shree-surya/PowerScope/(commit log)

2026-10-07 Import PowerScope and GridGuard project
    Firmware, bring-up sketches, web dashboard, host test harness, embed tool and docs.
    Claude-Session: https://claude.ai/code/session_018QBtkVoQuqfaWWn4kFVBk7
2026-10-07 Remove GridGuard: this repo is PowerScope only
    Delete the GridGuard spec and project page, and drop GridGuard from the
    README, CLAUDE.md, hardware layout and BOM (now a one-unit BOM).
    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
2026-10-07 Add calibration page behind a PIN, remove the energy reset
    Firmware 1.2.0: V_GAIN, I_TRIM, SHIFT, I_SIGN and I_NOISE now live in flash
    and are set from a new Calibrate section of the page. Voltage and current
    can be calibrated by typing the meter reading or the number itself; phase
    shift and current direction have a live PF check; zero current, restore
    defaults and change PIN are there too. All changes need the 4-digit PIN
    (default 1234, five wrong tries lock it for 60 s) and are applied in loop()
    between measuring windows. The energy reset button and POST /reset are gone.
    The host test stubs now keep Preferences and the web routes, and the run
    checks the whole calibration flow over HTTP, a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
    [Arduino.h, ESPAsyncWebServer.h, PowerScope.ino, Preferences.h, test_measure.cpp]
2026-10-07 Add energy history: daily and monthly kWh, bill estimate, charts, CSV
    Firmware 1.3.0: the page sends the phone's time (POST /time) whenever the
    device has none, i.e. after every power-up. Energy used before that is held
    aside (saved in flash) and added to the day the clock arrives on. 62 day
    slots and 12 month slots, tagged by day and month, are kept in flash with
    the energy total every 10 minutes and served by GET /energy. /data now
    carries the clock state, today's and this month's kWh. The OLED energy page
    shows today, this month and its cost.
    Page: today, this month, a month-end estimate, total measured, 30-day and
    12-month bar charts with tooltips, and a CSV of days and months. Billing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
2026-10-22 Fix compile error in the Arduino IDE: define Ring and Acc before the first function
    The Arduino IDE declares every function just above the first function in
    the sketch. The energy-history code added in 1.3.0 put uptimeMs() above
    the Ring and Acc structs, so the generated declarations of ringPush() and
    accStep() used undefined types. Moved the history-ring definitions up.
    The host test now builds the sketch the same way (tests/host/arduino_protos.py
    inserts the declarations first), and fails on the old file with the same
    error the IDE gave.
    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
2026-10-24 Add project documentation (Word and PDF) with block, wiring and mains diagrams
    Build guide, standard operating procedure and project report: specifications, how it works,
    components list, pin map, low-voltage and mains wiring diagrams, safety, assembly, pre-power
    checks, daily operation, flashing, calibration and acceptance tests, OLED and web page guide,
    troubleshooting, web API. Diagram PNGs in docs/diagrams.
    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
2026-10-27 Documentation: student project report version
    Cover with blank team / college / guide fields and a short mains warning; removed the contents,
    scope notes, notes on parts, tools, box layout, SOP, calibration and acceptance tables, limitations
    and appendices; components list without quantity and price; MCB shown without a rating; firmware
    comes from the provided zip instead of the repository.
    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
